ElektronikaDonBosco/Sordometro/electret-mic-pre-amp.jpg

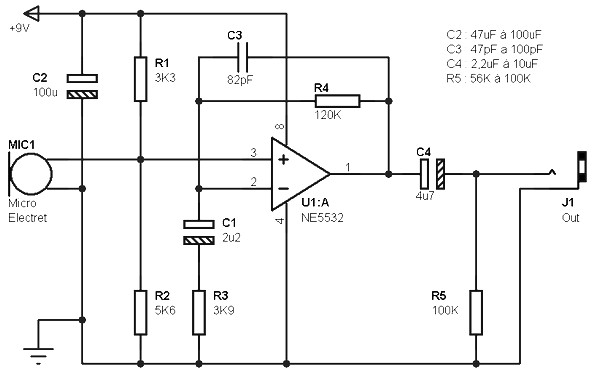
electret-mic-pre-amp.jpg
