ElektronikaDonBosco/Sordometro/funciones para programas/ejemplo_de_grafica_mark2__DB_boton/data/push.gif

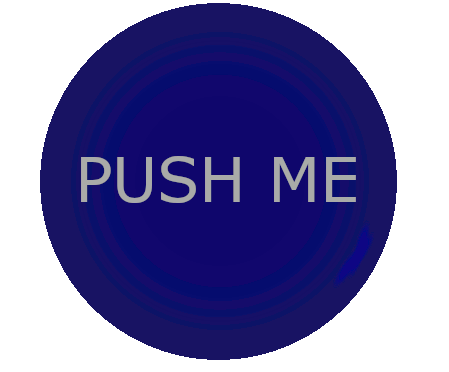
funciones para programas/ejemplo_de_grafica_mark2__DB_boton/data/push.gif
