ElektronikaDonBosco/Sordometro/funciones para programas/ejemplo_de_grafica_mark2__DB_boton/data/pushpulsado.gif

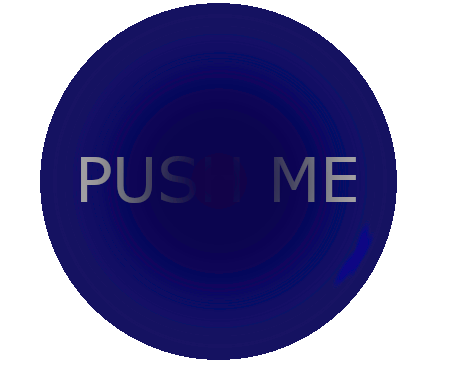
funciones para programas/ejemplo_de_grafica_mark2__DB_boton/data/pushpulsado.gif
