ElektronikaDonBosco/Sordometro/ImagenesReadME/PCB microfono electret.PNG

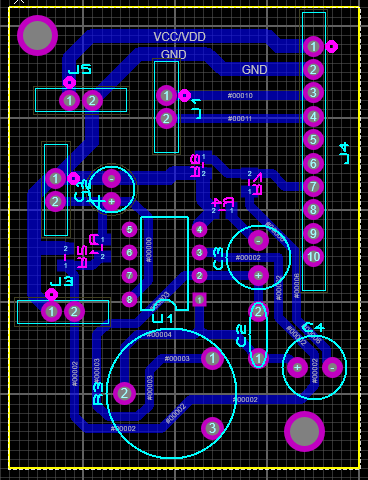
ImagenesReadME/PCB microfono electret.PNG
