ElektronikaDonBosco/Sordometro/(list of files, drawings)

Other design files:
microfono electrec version 2.pdsprj
