ElektronikaDonBosco/Sordometro/funciones para programas/muestre_a_fuerza/muestre_a_fuerza.pde

float muestra1=0;
float muestra2=0;
float muestra3=0;
float muestra4=0;
float muestra5=0;
float muestra6=0;
float muestra7=0;
float muestra8=0;
float muestra9=0;
float muestra10=0;
float muestra11=0;
float muestra12=0;
float muestra13=0;
float muestra14=0;
float muestra15=0;
float muestra16=0;
float muestra17=0;
float muestra18=0;
float muestra19=0;
float muestra21=0;
float muestra22=0;
float muestra23=0;
float muestra24=0;
float muestra25=0;
float muestra26=0;
float muestra27=0;
float muestra28=0;
float muestra29=0;
float muestra30=0;
float measured=adc.analogRead(0);
float suma=0;
float division=0;
void setup() {
}
void draw() {

  muestra1=round(measured);
  measured=adc.analogRead(0);
  muestra2=round(measured);
  measured=adc.analogRead(0);
  muestra3=round(measured);
  measured=adc.analogRead(0);
  muestra4=round(measured);
  measured=adc.analogRead(0);
  muestra5=round(measured);
  measured=adc.analogRead(0);
  muestra6=round(measured);
  measured=adc.analogRead(0);
  muestra7=round(measured);
  measured=adc.analogRead(0);
  muestra8=round(measured);
  measured=adc.analogRead(0);
  muestra9=round(measured);
  measured=adc.analogRead(0);
  muestra10=round(measured);
  measured=adc.analogRead(0);
  muestra11=round(measured);
  measured=adc.analogRead(0);
  muestra12=round(measured);
  measured=adc.analogRead(0);
  muestra13=round(measured);
  measured=adc.analogRead(0);
  muestra14=round(measured);
  measured=adc.analogRead(0);
  muestra15=round(measured);
  measured=adc.analogRead(0);
  muestra16=round(measured);
  measured=adc.analogRead(0);
  muestra17=round(measured);
  measured=adc.analogRead(0);
  muestra18=round(measured);
  measured=adc.analogRead(0);
  muestra19=round(measured);
  measured=adc.analogRead(0);
  muestra21=round(measured);
  measured=adc.analogRead(0);
  muestra22=round(measured);
  measured=adc.analogRead(0);
  muestra23=round(measured);
  measured=adc.analogRead(0);
  muestra24=round(measured);
  measured=adc.analogRead(0);
  muestra25=round(measured);
  measured=adc.analogRead(0);
  muestra26=round(measured);
  measured=adc.analogRead(0);
  muestra27=round(measured);
  measured=adc.analogRead(0);
  muestra28=round(measured);
  measured=adc.analogRead(0);
  muestra29=round(measured);
  measured=adc.analogRead(0);
  muestra30=round(measured);
  

  suma=muestra1+muestra2+muestra3+muestra4+muestra5+muestra6+muestra7+muestra8+muestra9+muestra10+muestra11+muestra12+muestra13+muestra14+muestra15+muestra16+muestra17+muestra18+muestra19+muestra21+muestra22+muestra23+muestra24+muestra25+muestra26+muestra27+muestra28+muestra29+muestra30;
    division=suma/30;
    println(division);
   
}
